Toufupi/DigitalClock/2.SourceCode/SourceCode.md

本项目使用Arduino IDE编写 \n
使用三个三方库
需要安装ESP库支持
<h1>使用到的第三方库\n
    Wifi_link_tool 用于实现wifi配网
