Toufupi/DigitalClock/0.PCB/Digital_clock.kicad_pcb

## KiCad design 0.PCB/Digital_clock.kicad_pcb (2021-02-23)

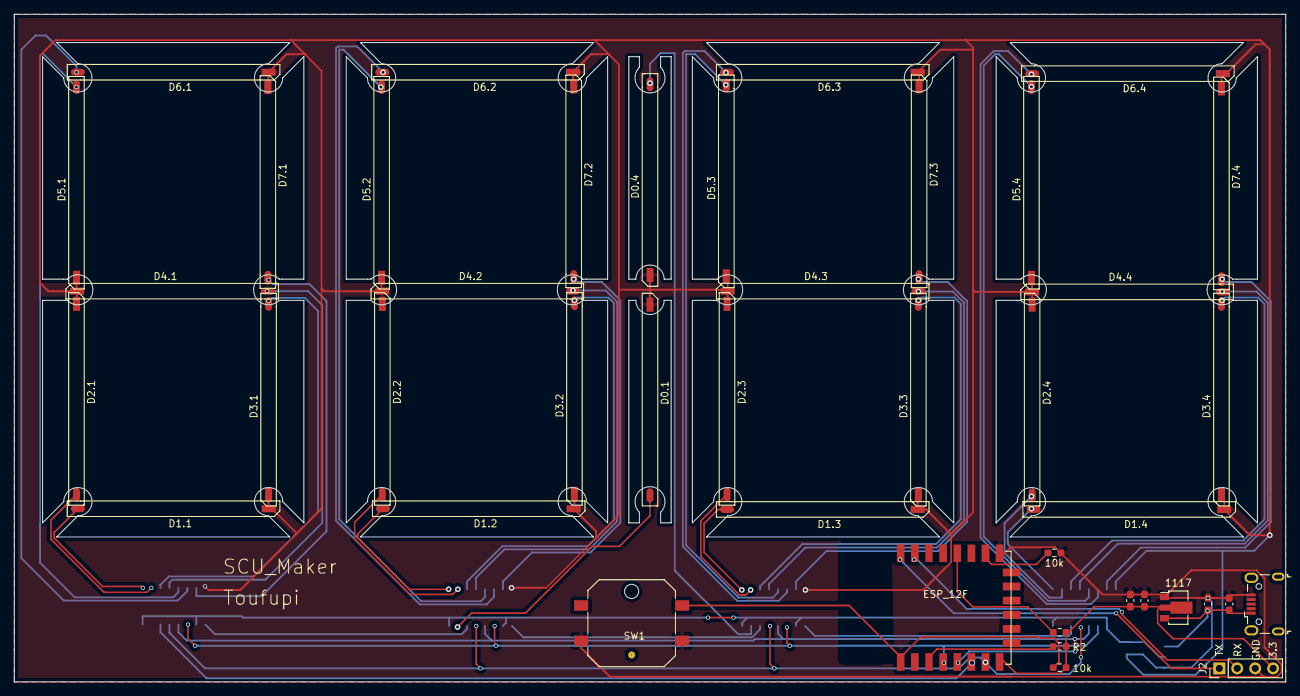
[picture p1: board Digital_clock.kicad_pcb from above]

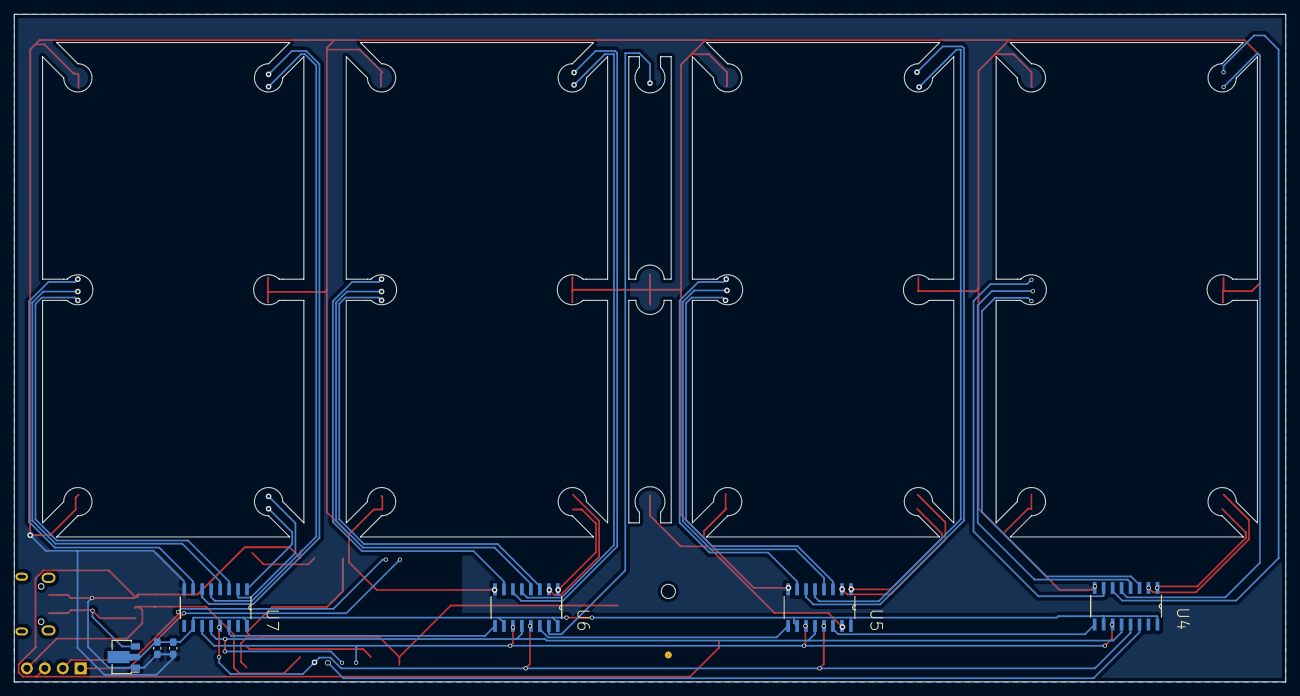
[picture p2: board Digital_clock.kicad_pcb from below]

Board: 2 copper layers, 180.0 x 94.5 mm, 50 parts (7 on the bottom side), 47 nets.

Parts:
10k, 10k#2: 10k; R_0603_1608Metric_Pad0.98x0.95mm_HandSolder
1117: AZ1117-3.3; SOT-89-3
C1, C4, C6: 10uf; C_0603_1608Metric_Pad1.08x0.95mm_HandSolder
C2, C3, C5: 0.1uf; C_0603_1608Metric_Pad1.08x0.95mm_HandSolder
D0.1, D0.4, D1.1, D1.2, D1.3, D1.4, D2.1, D2.2, D2.3, D2.4, D3.1, D3.2, D3.3, D3.4, D4.1, D4.2, D4.3, D4.4, D5.1, D5.2, D5.3, D5.4, D6.1, D6.2, D6.3, D6.4, D7.1, D7.2, D7.3, D7.4: LED; led_26mm
ESP_12F: ESP-12F; ESP-12E_SMD
J1: USB_B_Micro; USB_Micro-B_Wuerth_629105150521
J2: Conn_01x04; PinHeader_1x04_P2.54mm_Vertical
R2, R3: 10k; R_0603_1608Metric_Pad0.98x0.95mm_HandSolder
SW1: SW_DIP_x01; SW_Push_1P1T_NO_CK_PTS125Sx43PSMTR
U2: AZ1117-3.3; SOT-89-3
U4, U5, U6, U7: 74HC595D,118; SOIC127P600X175-16N

Connections:
/5v: 1117.3, C1.1, C2.1, J1.1, U2.3
/DS: ESP_12F.6, U4.14
/GND: 10k.1, 1117.1, C1.2, C2.2, C3.2, C4.2, C5.2, C6.2, D0.1.1, D0.4.1, D1.1.1, D1.2.1, D1.3.1, D1.4.1, D2.1.1, D2.2.1, D2.3.1, D2.4.1, D3.1.1, D3.2.1, D3.3.1, D3.4.1, D4.1.1, D4.2.1, D4.3.1, D4.4.1, D5.1.1, D5.2.1, D5.3.1, D5.4.1, D6.1.1, D6.2.1, D6.3.1, D6.4.1, D7.1.1, D7.2.1, D7.3.1, D7.4.1, ESP_12F.9, J1.5, J2.3, SW1.2, U2.1, U4.8, U5.8, U6.8, U7.8
/OE: ESP_12F.7, U4.13, U5.13, U6.13, U7.13
/SH_CP: ESP_12F.4, U4.11, U5.11, U6.11, U7.11
/ST_CP: ESP_12F.5, U4.12, U5.12, U6.12, U7.12
unnamed: C3.1, C4.1, U2.2, U4.10, U4.16, U5.10, U5.16, U6.10, U6.16, U7.10, U7.16
unnamed: 10k#2.2, 1117.2, C5.1, C6.1, ESP_12F.8, J2.4, R2.2, R3.1
unnamed: D0.1.2, U5.15
unnamed: D0.4.2, U6.15
unnamed: D1.1.2, U4.1
unnamed: D1.2.2, U5.1
unnamed: D1.3.2, U6.1
unnamed: D1.4.2, U7.1
unnamed: D2.1.2, U4.2
unnamed: D2.2.2, U5.2
unnamed: D2.3.2, U6.2
unnamed: D2.4.2, U7.2
unnamed: D3.1.2, U4.3
unnamed: D3.2.2, U5.3
unnamed: D3.3.2, U6.3
unnamed: D3.4.2, U7.3
unnamed: D4.1.2, U4.4
unnamed: D4.2.2, U5.4
unnamed: D4.3.2, U6.4
unnamed: D4.4.2, U7.4
unnamed: D5.1.2, U4.5
unnamed: D5.2.2, U5.5
unnamed: D5.3.2, U6.5
unnamed: D5.4.2, U7.5
unnamed: D6.1.2, U4.6
unnamed: D6.2.2, U5.6
unnamed: D6.3.2, U6.6
unnamed: D6.4.2, U7.6
unnamed: D7.1.2, U4.7
unnamed: D7.2.2, U5.7
unnamed: D7.3.2, U6.7
unnamed: D7.4.2, U7.7
unnamed: ESP_12F.16, J2.1
unnamed: ESP_12F.15, J2.2
unnamed: 10k#2.1, ESP_12F.1, SW1.1
unnamed: ESP_12F.3, R2.1
unnamed: ESP_12F.12, R3.2
unnamed: 10k.2, ESP_12F.10
unnamed: U4.9, U5.14
unnamed: U5.9, U6.14
unnamed: U6.9, U7.14
