Toufupi/DigitalClock/(threads)

Thread 1 (2021-02-23):

长时间运行导致第一个595过热数据无法串行输出

Toufupi, 2021-02-23:
长时间运行问题，怀疑与写入次数过多有关，尝试降低数据传入频率

Toufupi, 2021-02-23:
继续测试发现，在运行一段时间后，后三位595变为全输出模式，仅第一位正常显示，怀疑短路或者程序问题

Toufupi, 2021-02-23:
更正，具有一定的概率性，无法确定与运行时间的关系，确定非数据溢出的问题

Toufupi, 2021-02-24:
目前怀疑问题在于输出电流过大，下一版加入限流电阻

Toufupi, 2021-02-25:
情况更新：在出现问题时。电流明显增大，约为三倍，怀疑有短路问题。并且与运行时间无明显关联

Toufupi, 2021-02-25:
确认非软件问题，基本确认是硬件设计问题
